mateuszjanuszewski03/wireless-temp-station/receiver/receiverPCB.pdf

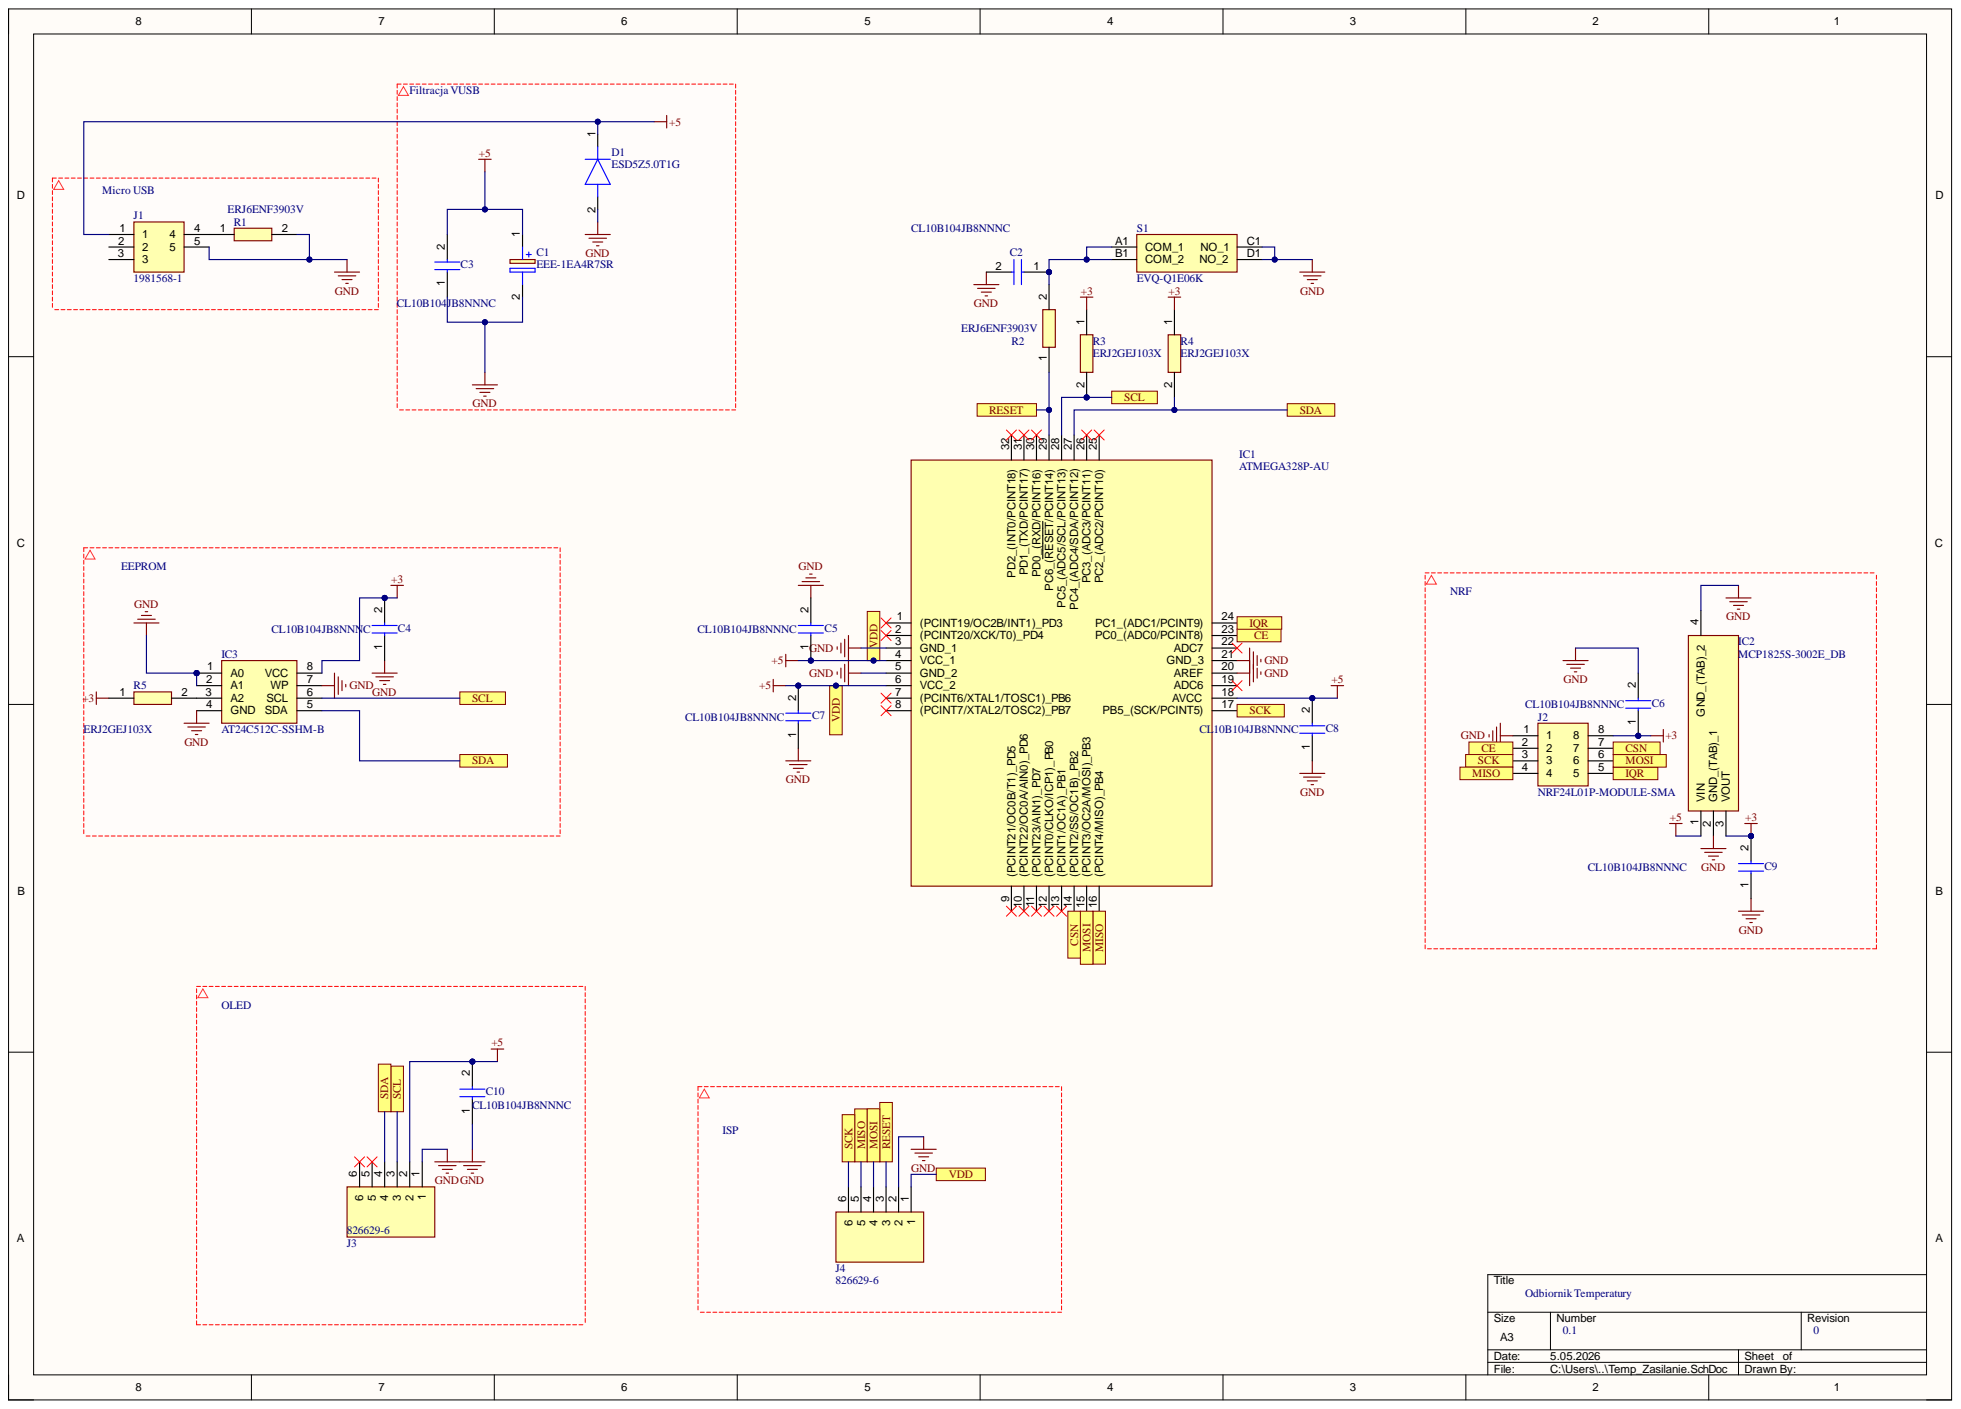
[picture p1: page 1]

E | | | CSN

M ISO | | C | I Q R

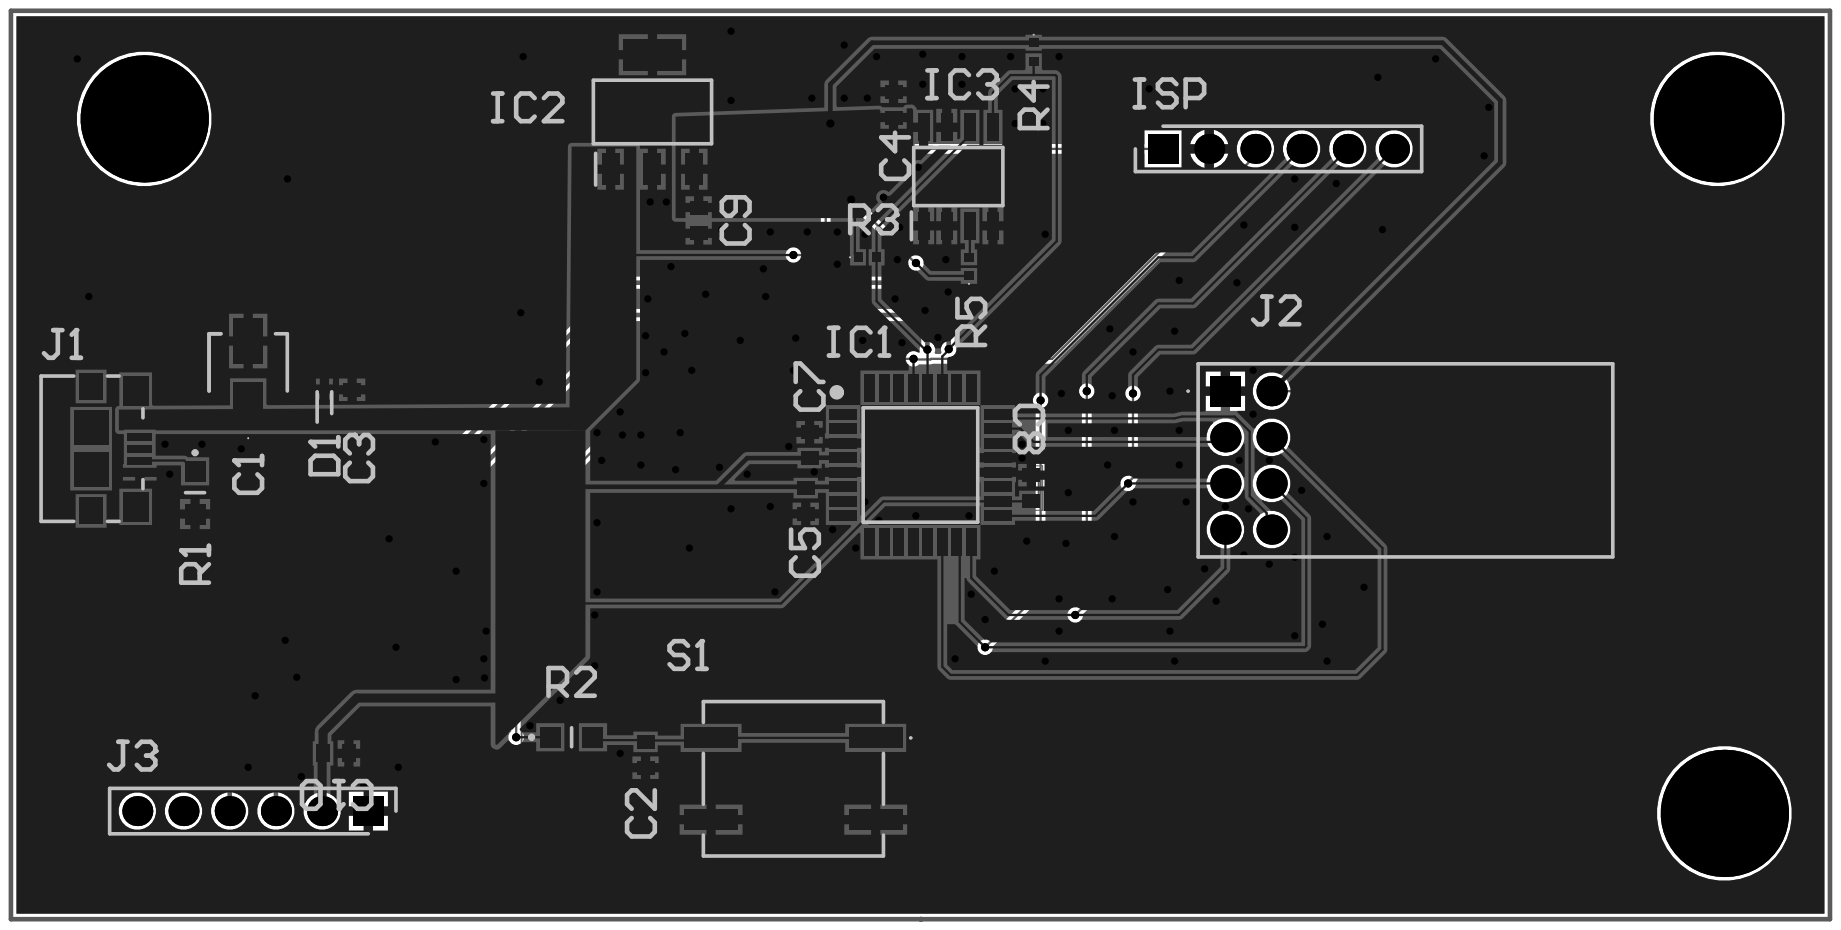
[picture p2: page 2]

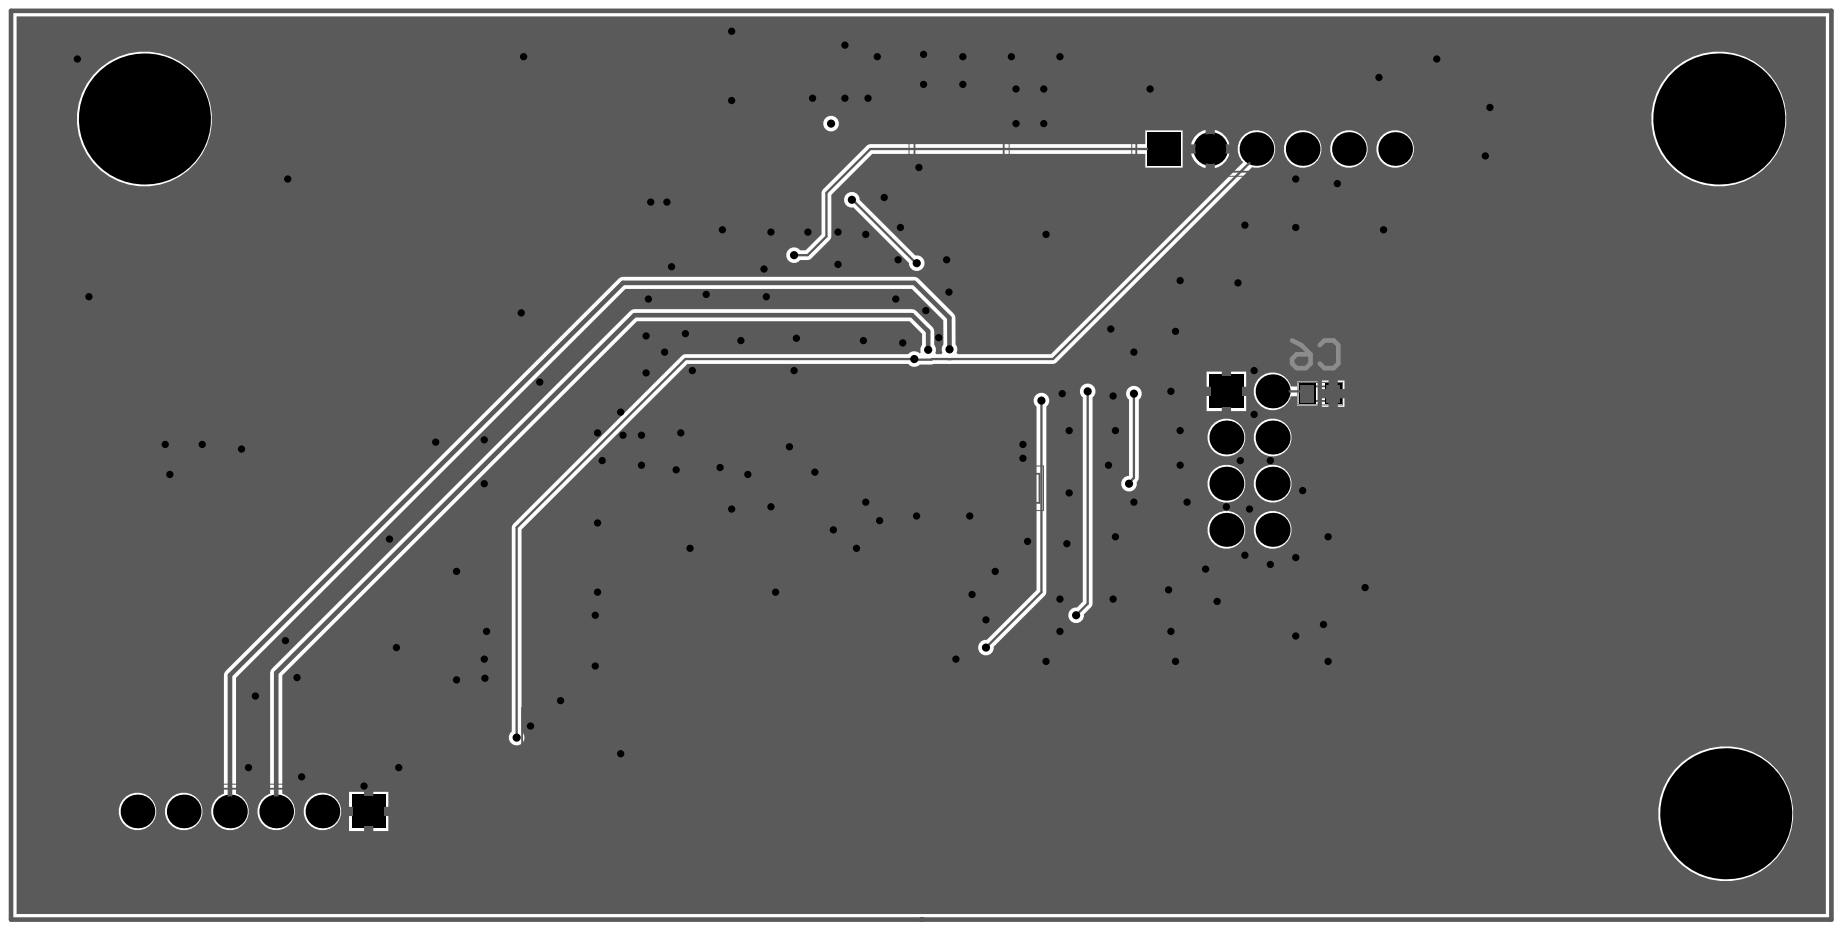
[picture p3: page 3]

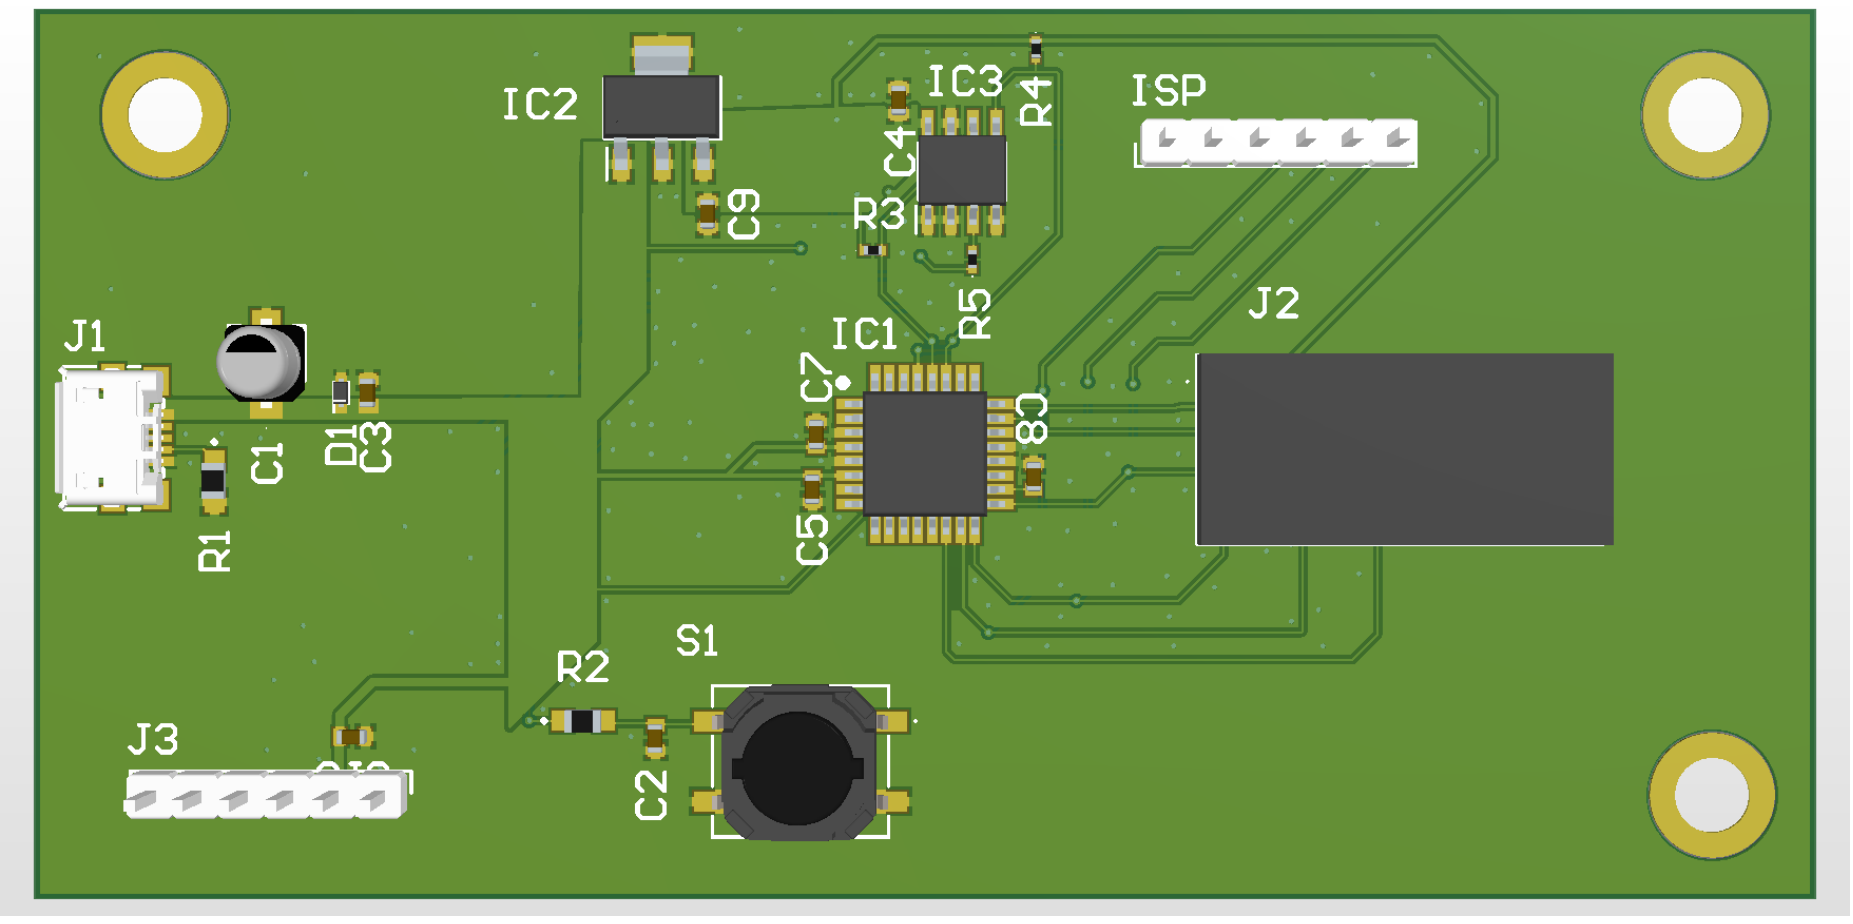
[picture p4: page 4]

Name | Description | Designator | Quantity
826629-6 | Connector | J3, J4 | 2
1981568-1 | Connector | J1 | 1
AT24C512C-SSHM-B | Integrated Circuit | IC3 | 1
ATMEGA328P-AU | Integrated Circuit | IC1 | 1
CL10B104JB8NNNC | Capacitor | C2, C3, C4, C5, C6, C7, C8, C9, C10 | 9
EEE-1EA4R7SR | Capacitor Polarised | C1 | 1
ERJ2GEJ103X | Resistor | R3, R4, R5 | 3
ERJ6ENF3903V | Resistor | R1 | 1
ERJ6ENF3903V | Resistor | R2 | 1
ESD5Z5.0T1G | Diode | D1 | 1
EVQ-Q1E06K | Switch | S1 | 1
MCP1825S-3002E_DB | Integrated Circuit | IC2 | 1
NRF24L01P-MODULE-SMA | Connector | J2 | 1
