mateuszjanuszewski03/wireless-temp-station/sensor/sensorPCB.pdf

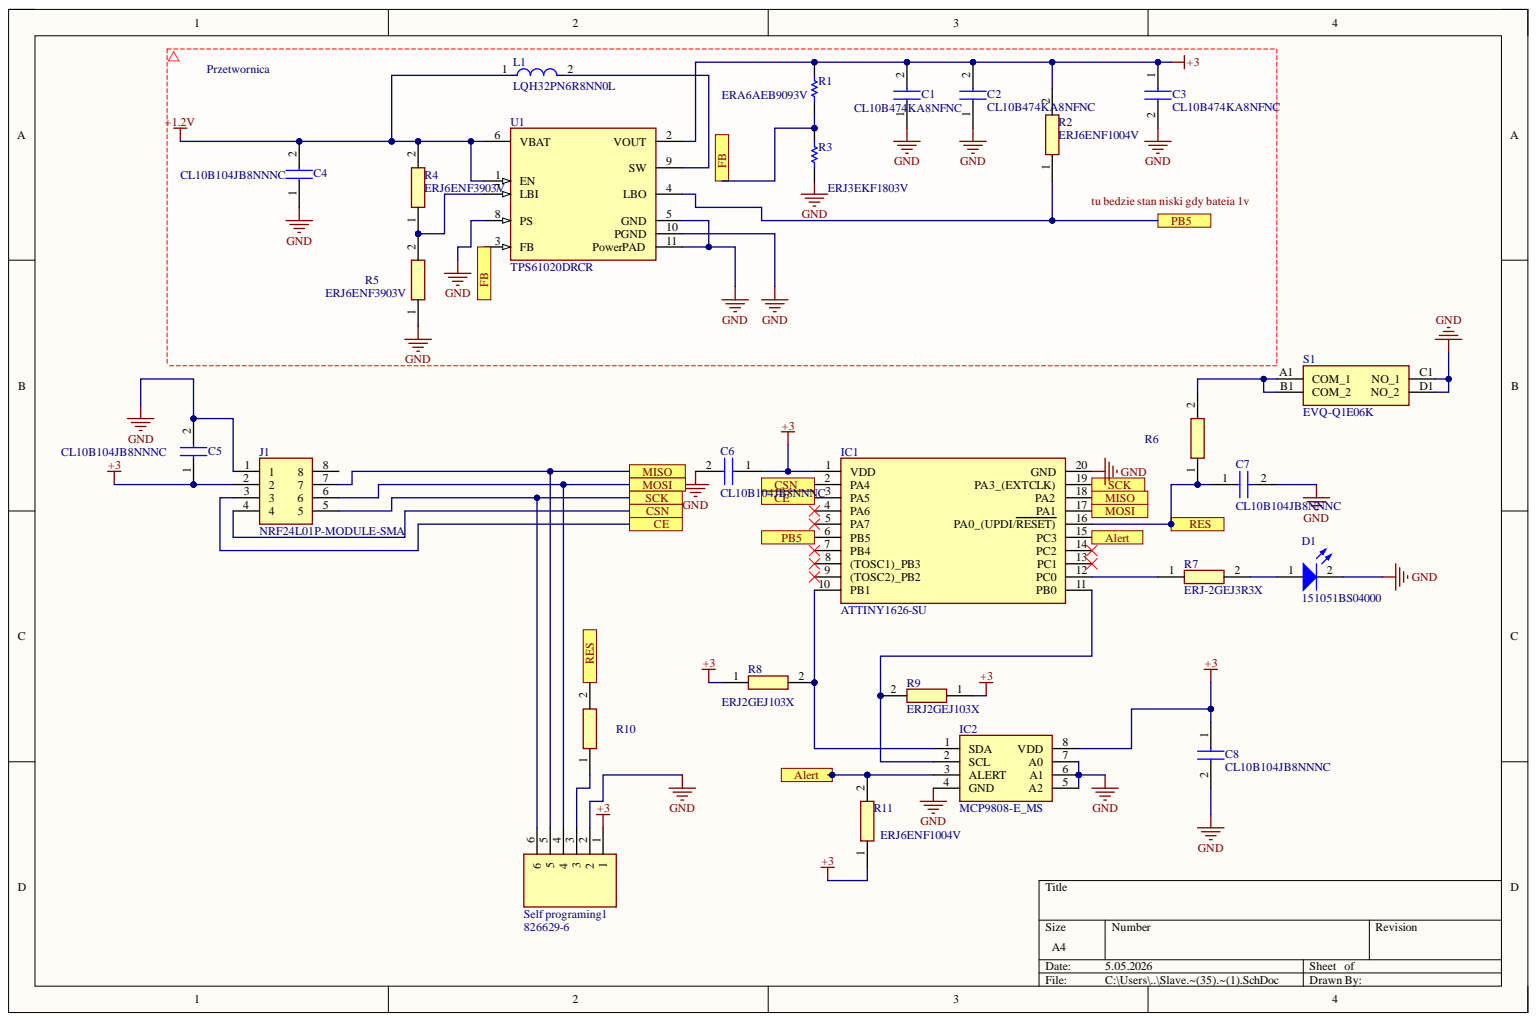
[picture p5: page 1]

tu bedzie stan niski gdy bateia 1v

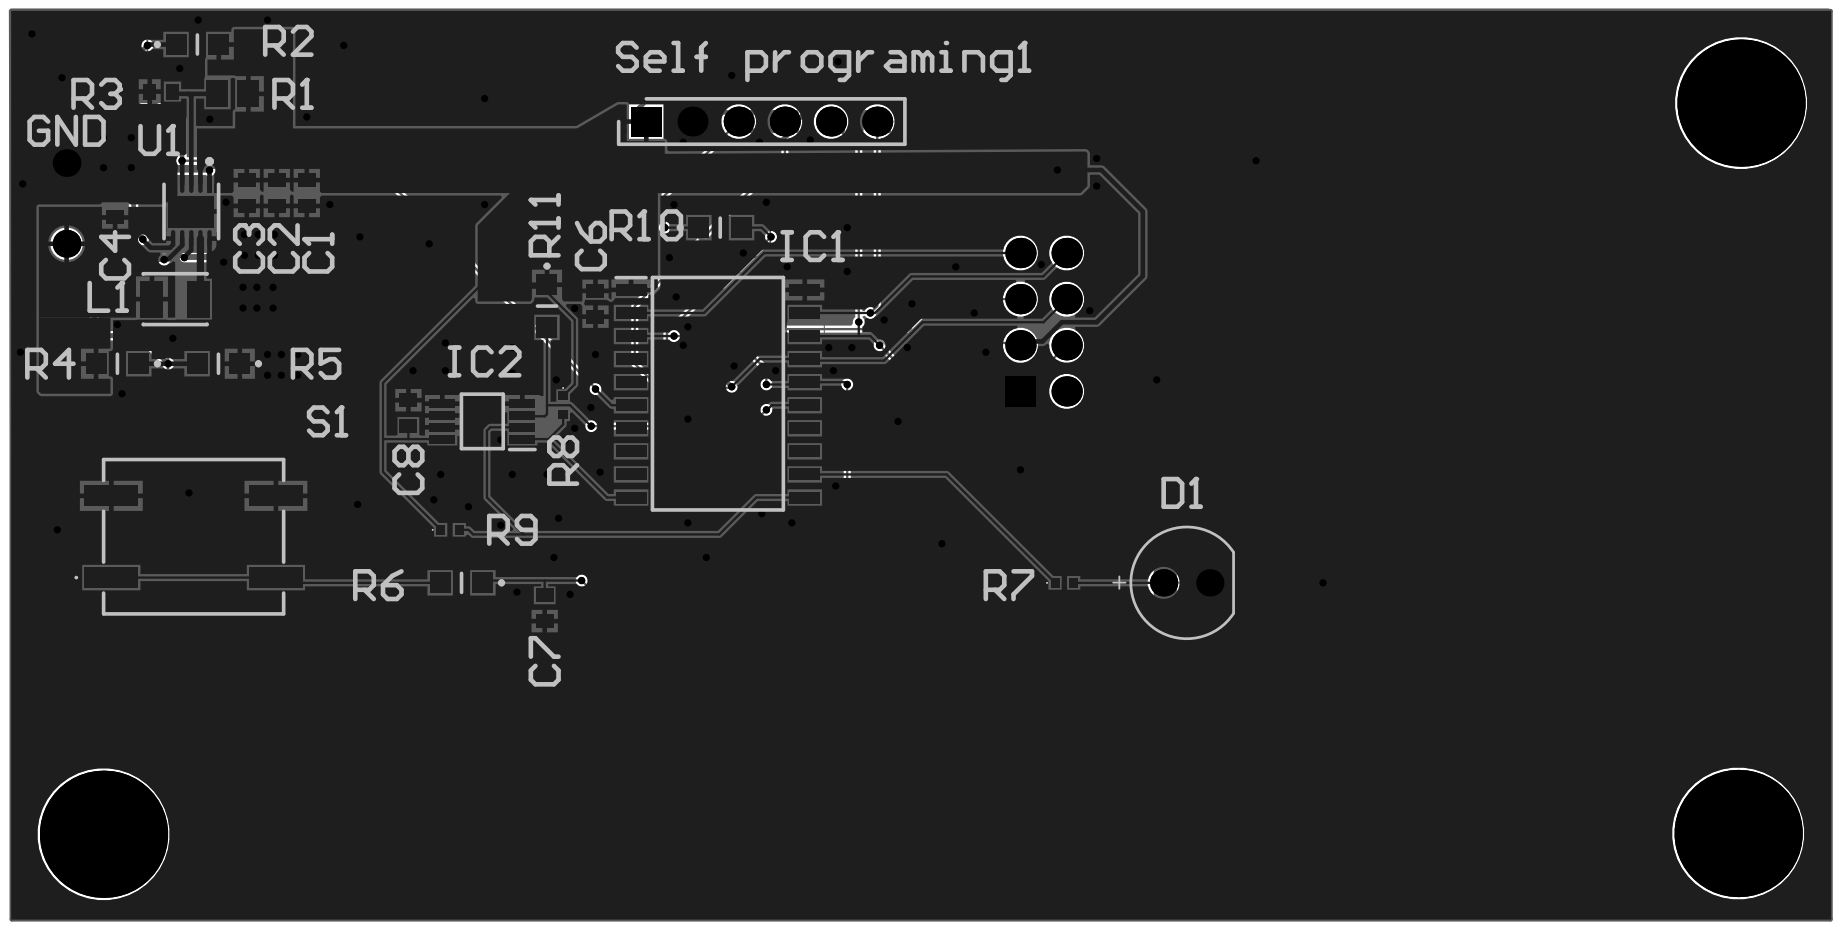
[picture p6: page 2]

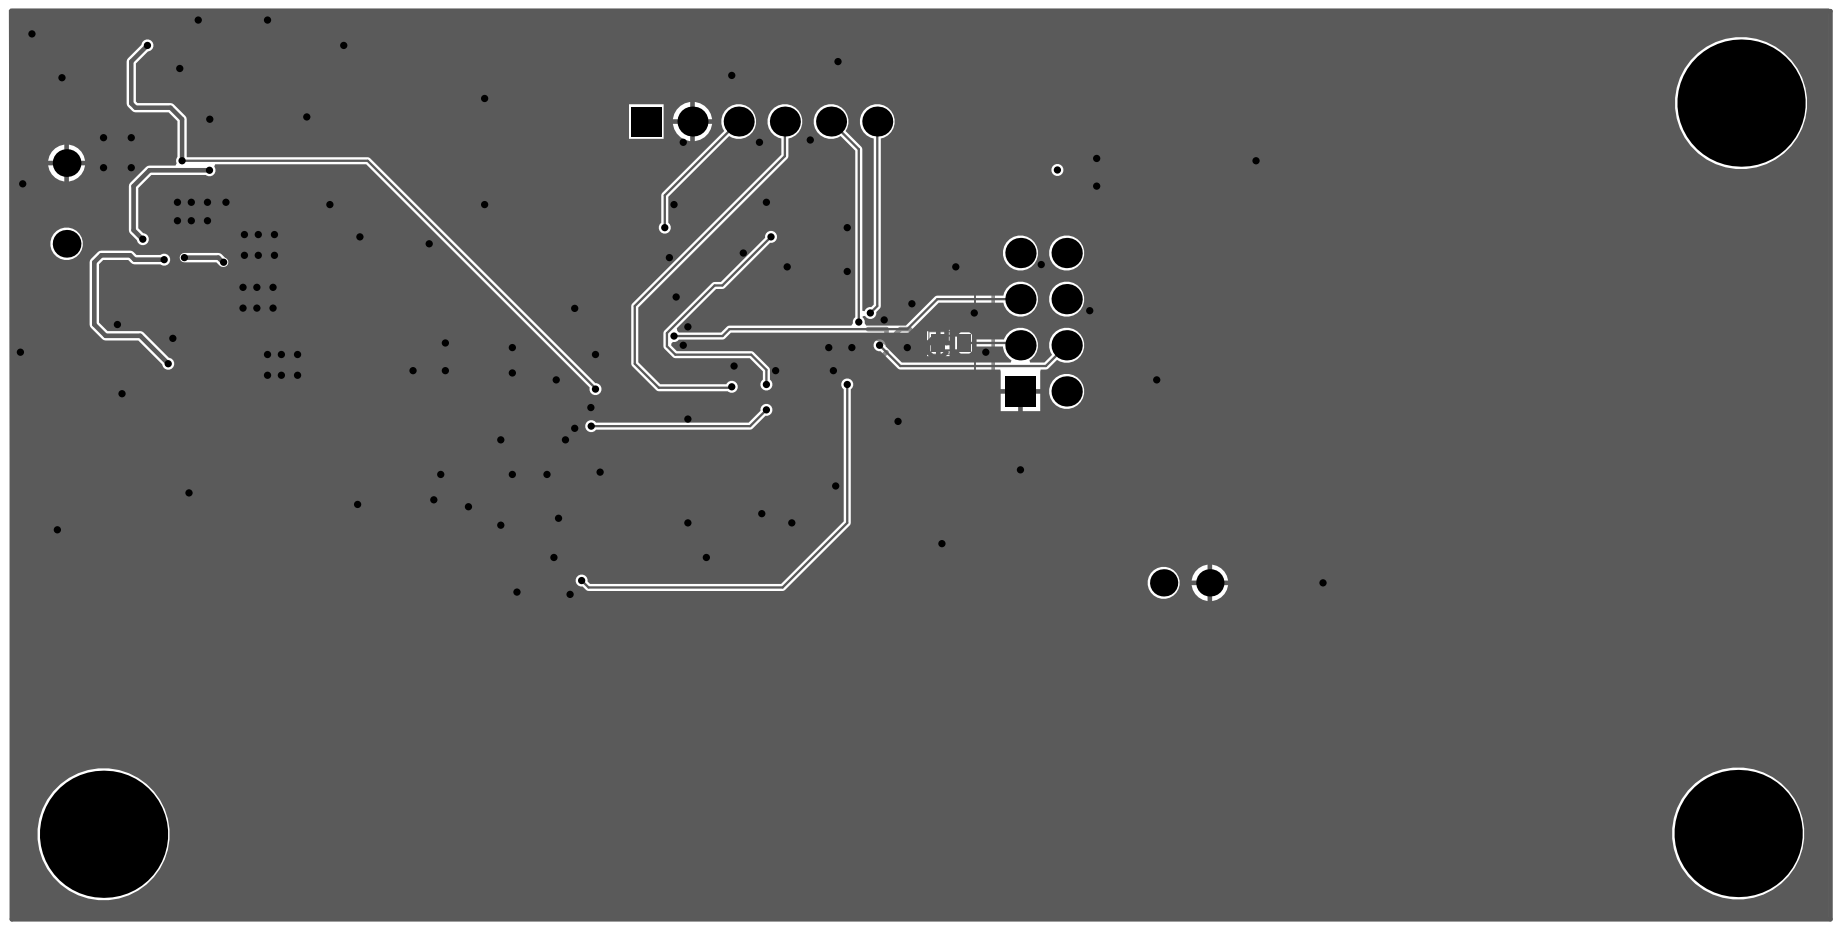
[picture p7: page 3]

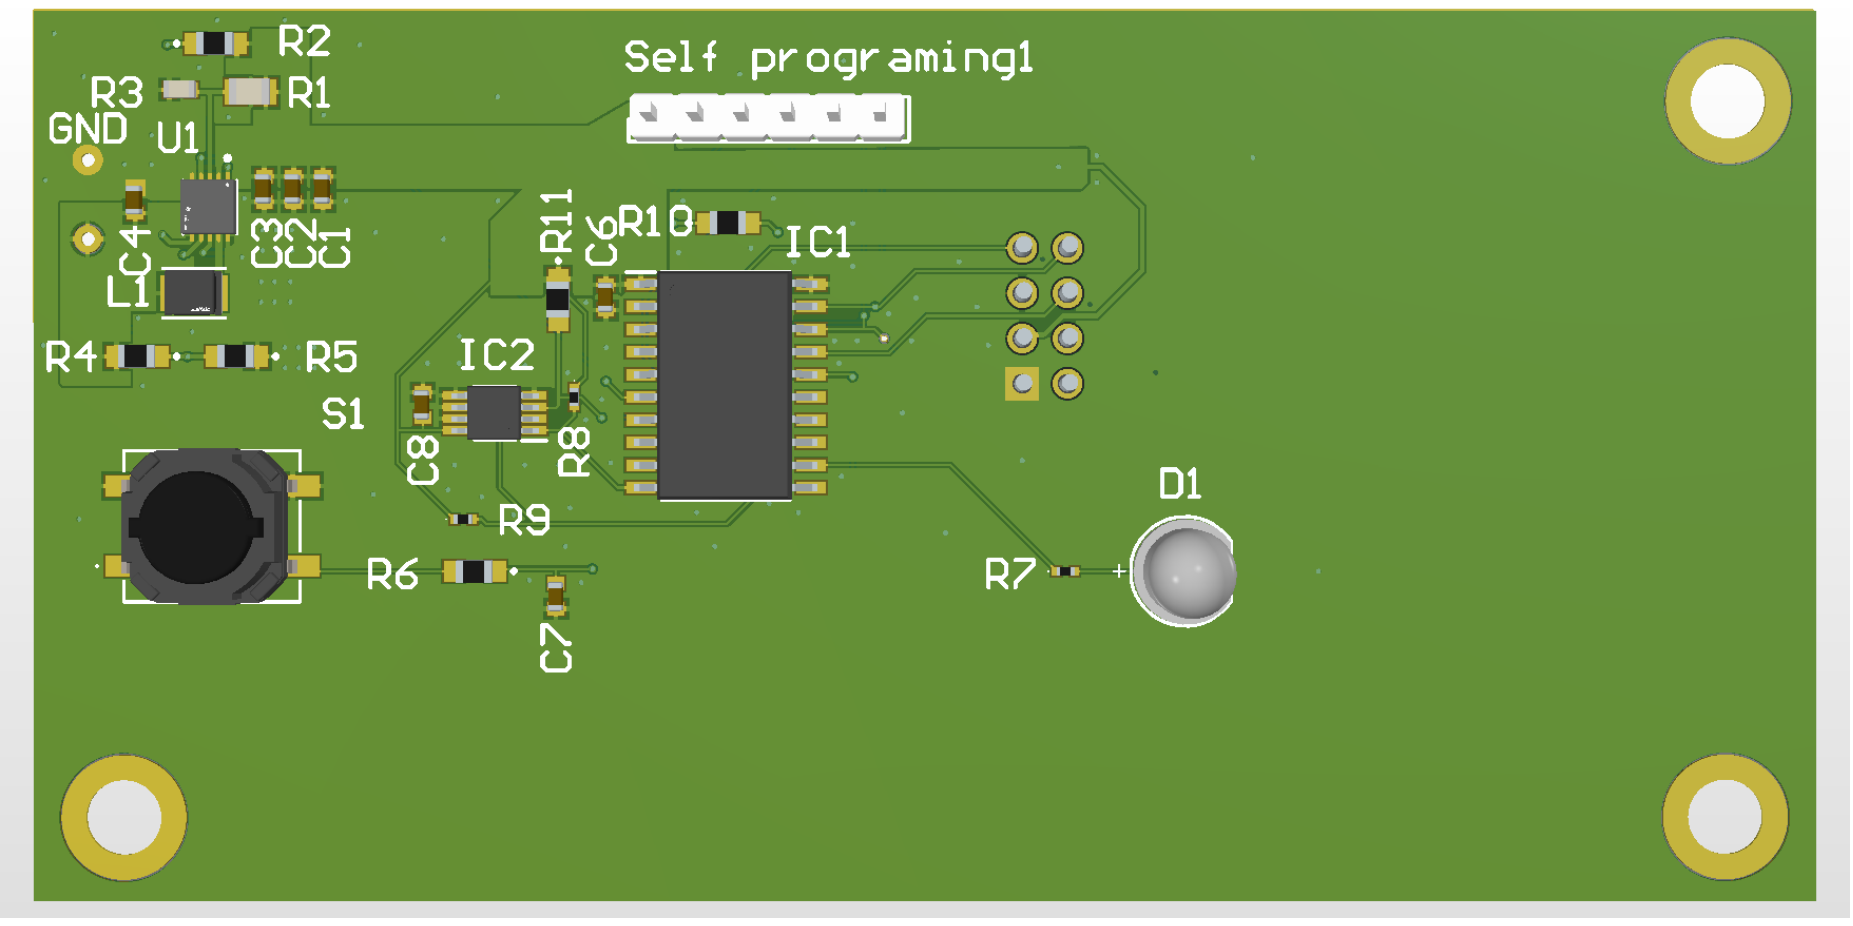
[picture p8: page 4]

Name | Description | Designator | Quantity
CL10B104JB8NNN C | Capacitor | C4, C5, C6, C7, C8 | 5
ERJ6ENF3903V | Resistor | R4, R5, R6, R10 | 4
CL10B474KA8NFN C | Capacitor | C1, C2, C3 | 3
ERJ2GEJ103X | Resistor | R8, R9 | 2
ERJ6ENF1004V | Resistor | R2, R11 | 2
151051BS04000 | | D1 | 1
826629-6 | Connector | Self programing1 | 1
ATTINY1626-SU | Integrated Circuit | IC1 | 1
ERA6AEB9093V | | R1 | 1
ERJ3EKF1803V | | R3 | 1
ERJ-2GEJ3R3X | Resistor | R7 | 1
EVQ-Q1E06K | Switch | S1 | 1
LQH32PN6R8NN0 L | Wire Wound Ferrite Inductor for Power Lines 6.8μH ±30% 0.288Ω 850mA 1210 | L1 | 1
MCP9808-E_MS | Integrated Circuit | IC2 | 1
NRF24L01P-MODULE-SMA | Connector | J1 | 1
TPS61020DRCR | IC REG BOOST ADJ 1.5A 10VSON | U1 | 1
