mateuszjanuszewski03/wireless-temp-station/(commit log)

2026-04-17 add code sensor
2026-04-23 Add a README file and fix the clock function
    [main.c]
2026-05-05 add PCB file
